gix-mkrspc/internet-of-porg/assets/9.jpeg

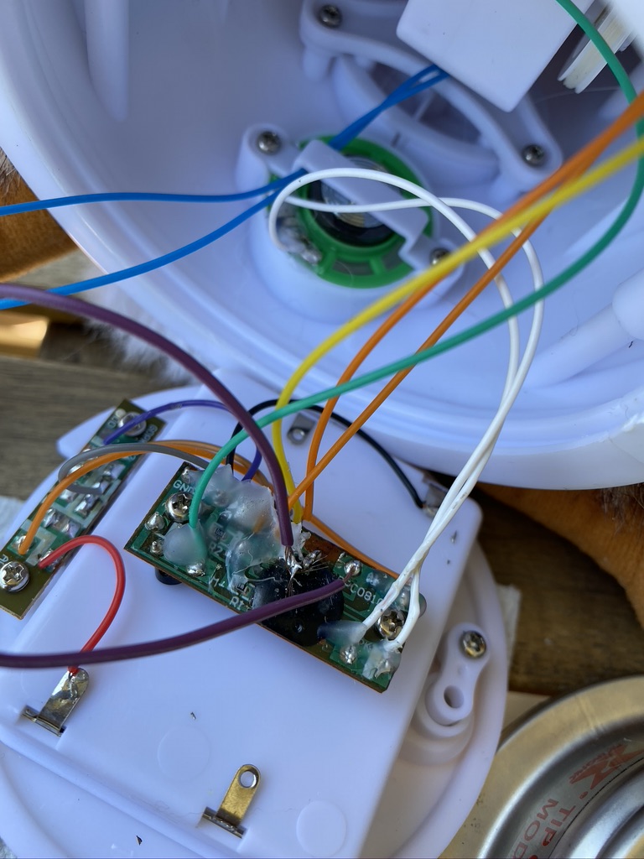
assets/9.jpeg
