gix-mkrspc/internet-of-porg/assets/14.png

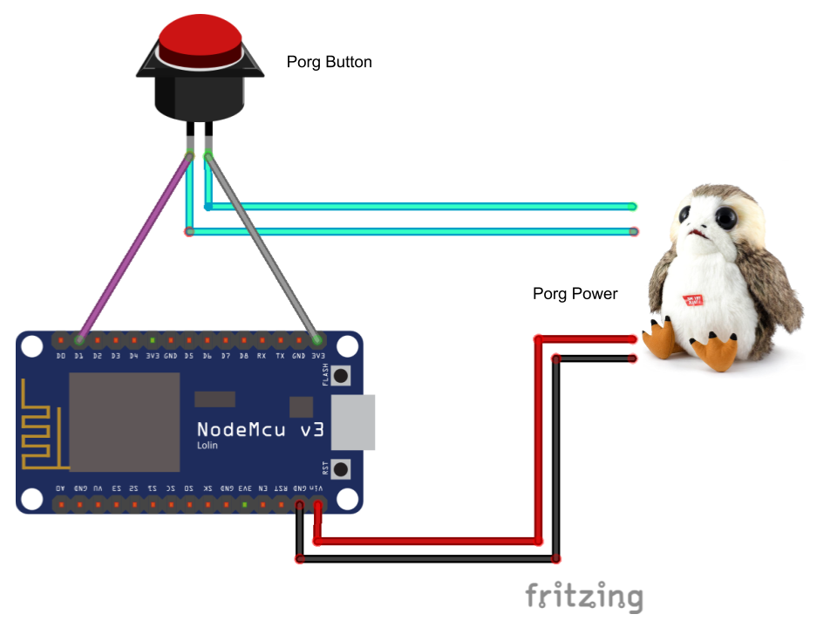
assets/14.png
