gix-mkrspc/internet-of-porg/assets/arduino_bb.png

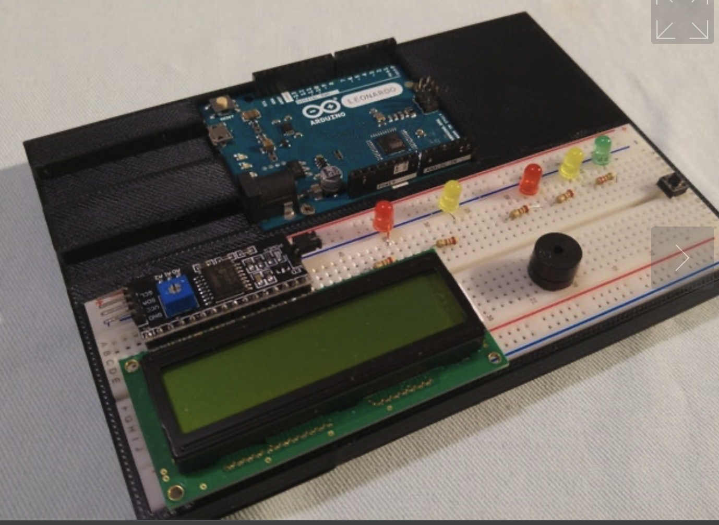
assets/arduino_bb.png
