gix-mkrspc/internet-of-porg/assets/azure/1.png

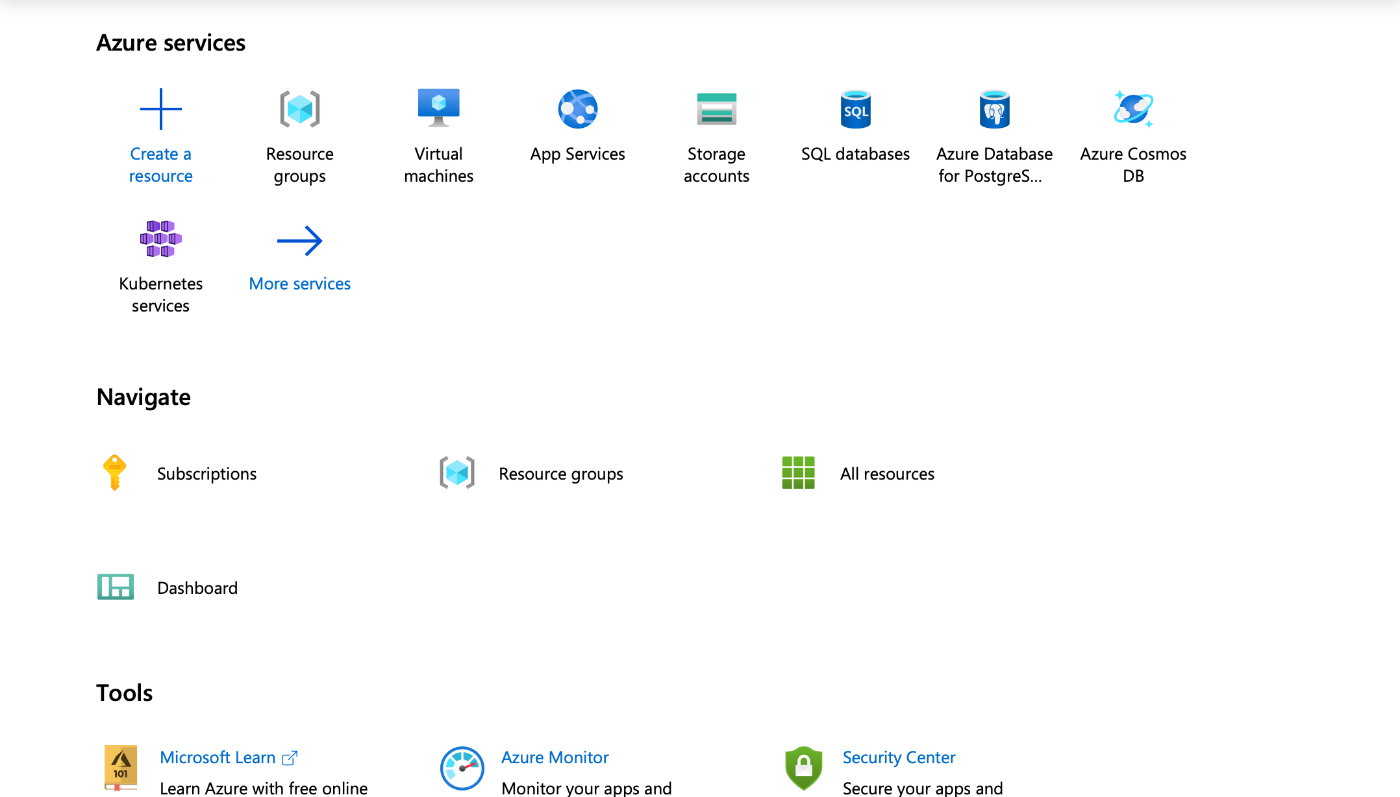
assets/azure/1.png
