gix-mkrspc/internet-of-porg/assets/azure/2.png

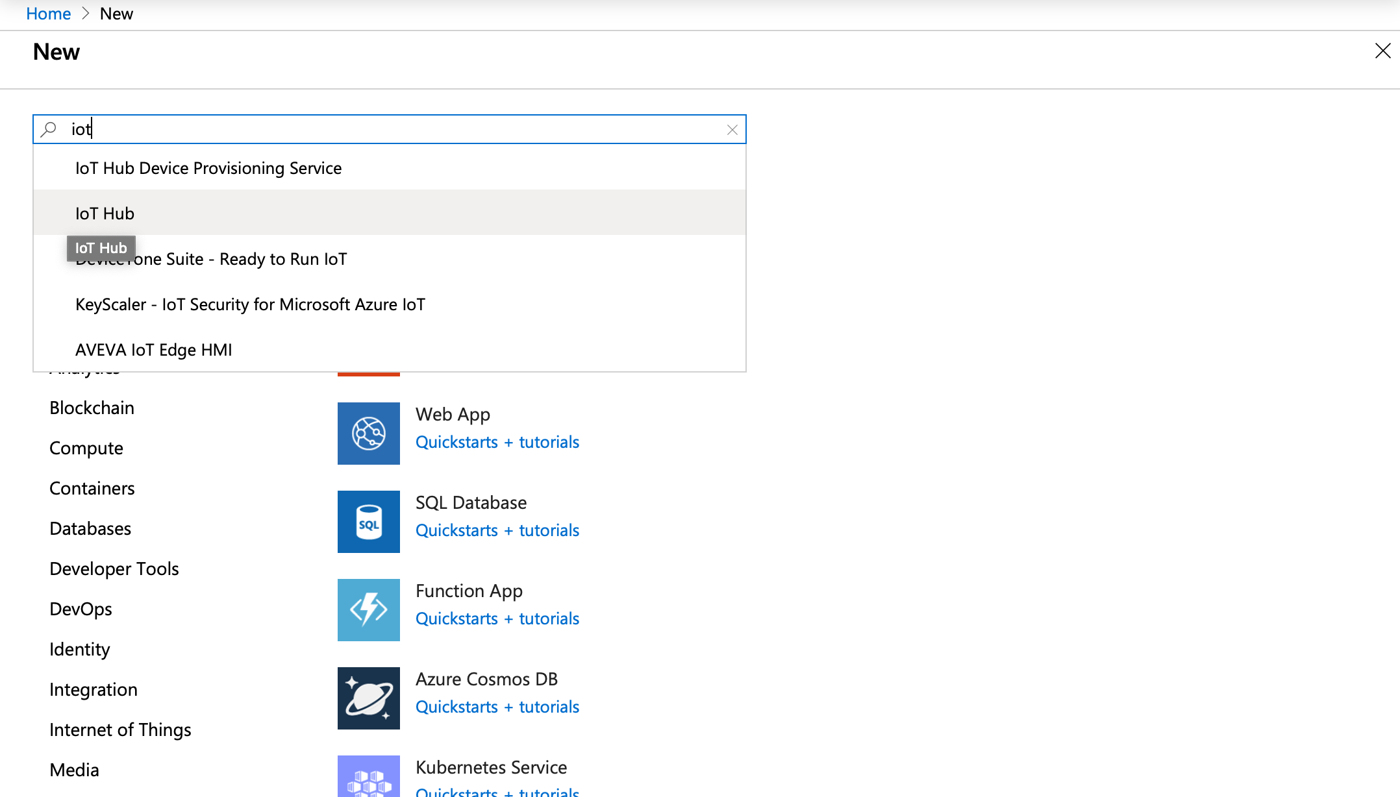
assets/azure/2.png
