gix-mkrspc/internet-of-porg/assets/azure/3.png

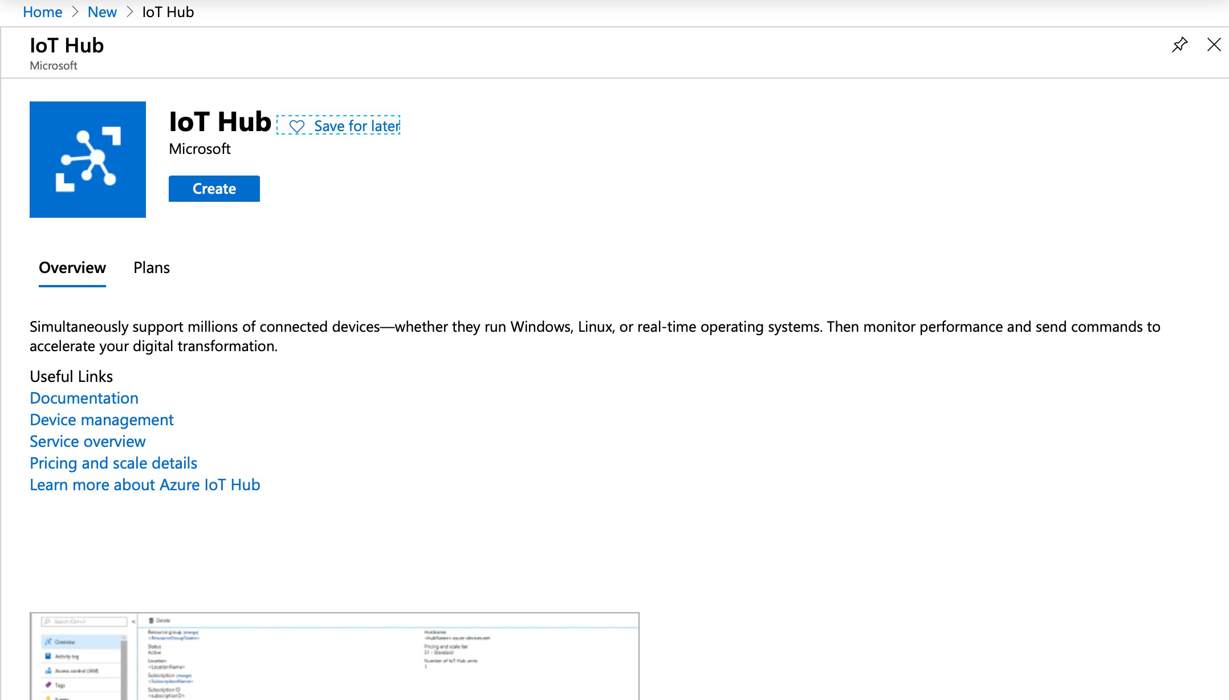
assets/azure/3.png
