gix-mkrspc/internet-of-porg/assets/azure/4.png

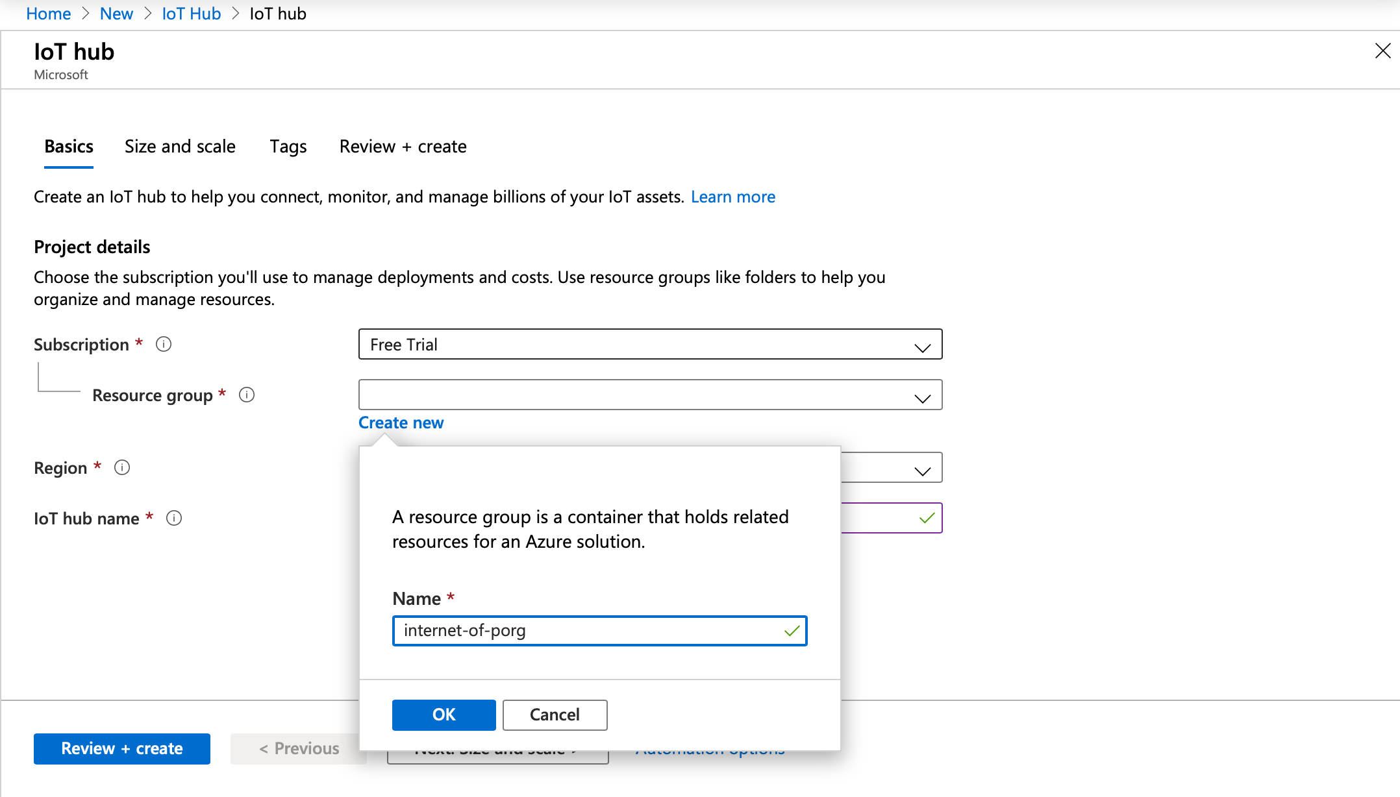
assets/azure/4.png
