gix-mkrspc/internet-of-porg/assets/azure/5.png

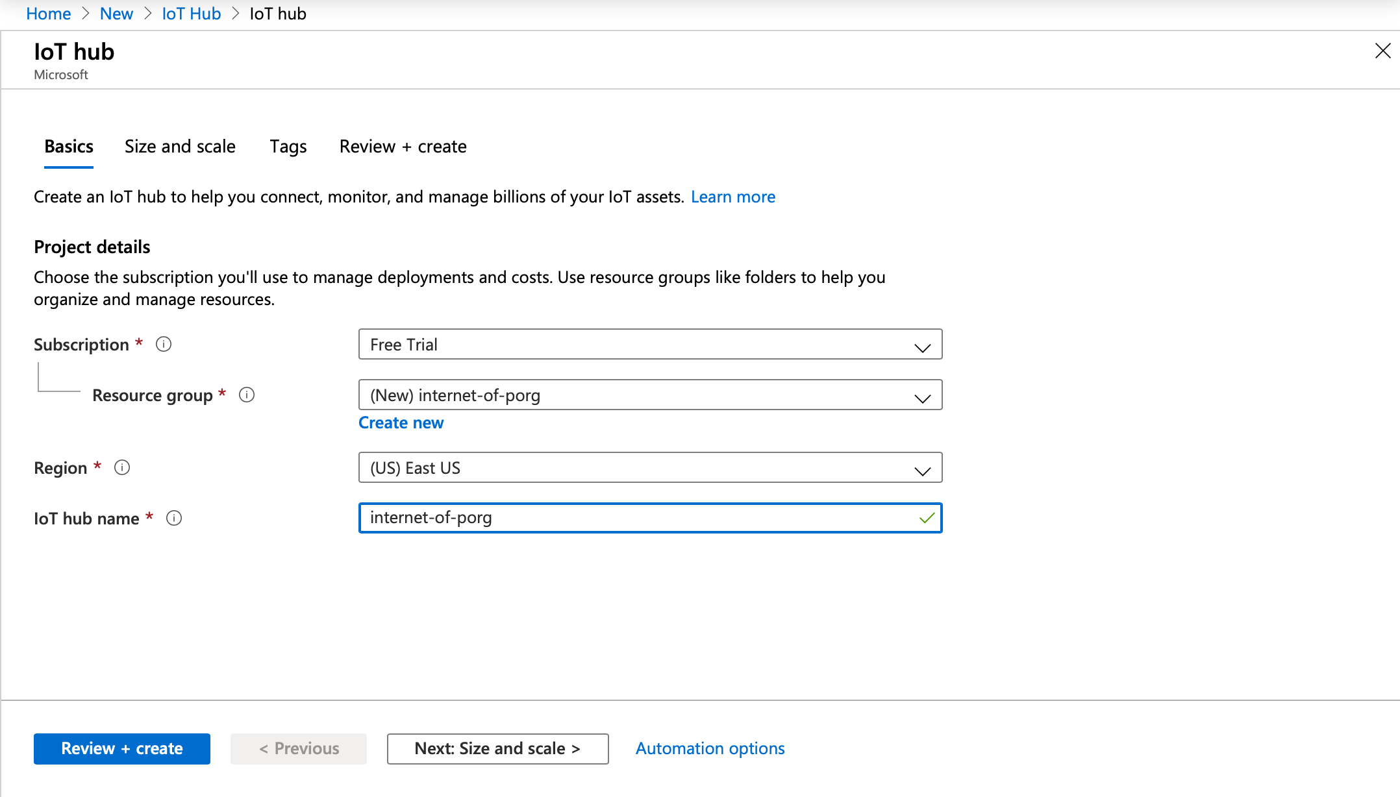
assets/azure/5.png
