gix-mkrspc/internet-of-porg/assets/azure/6.png

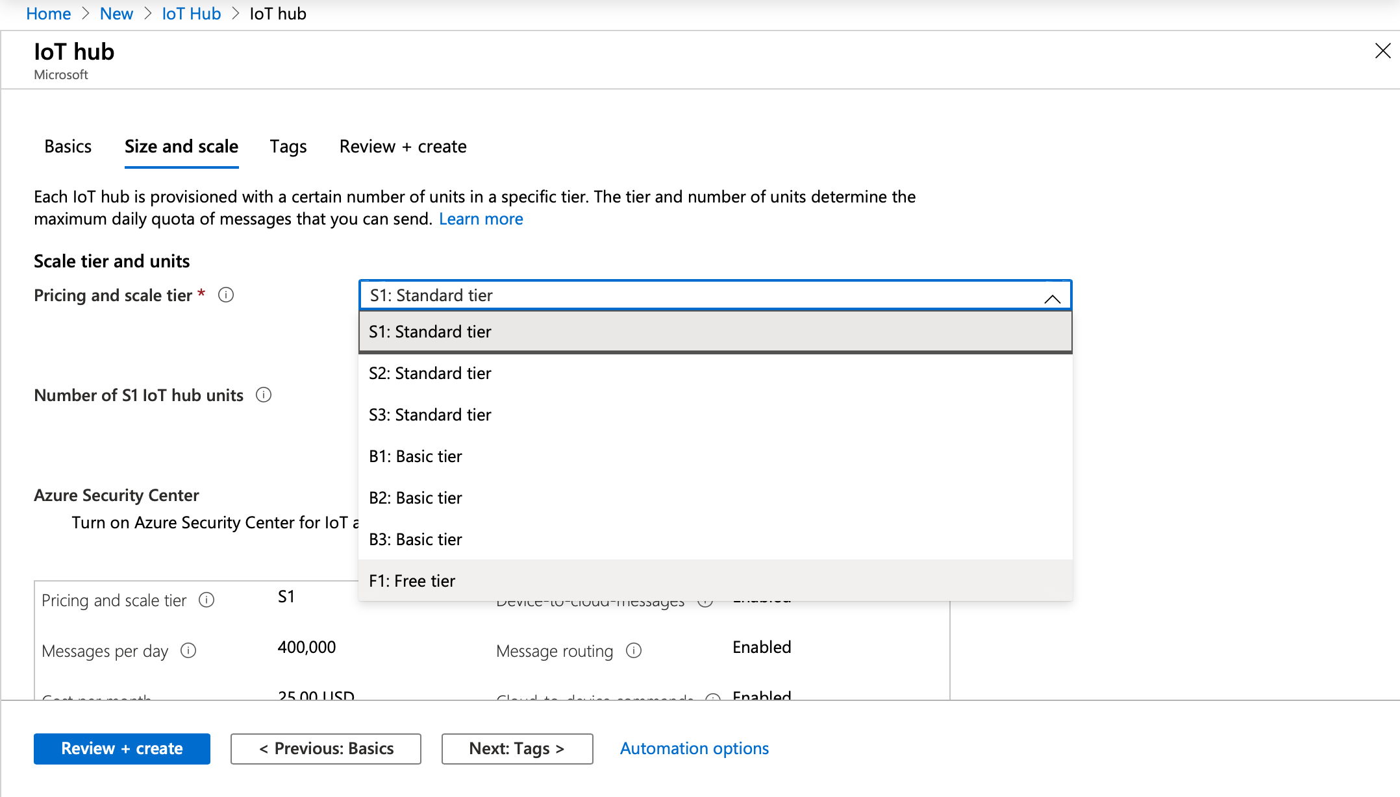
assets/azure/6.png
