gix-mkrspc/internet-of-porg/assets/azure/7.png

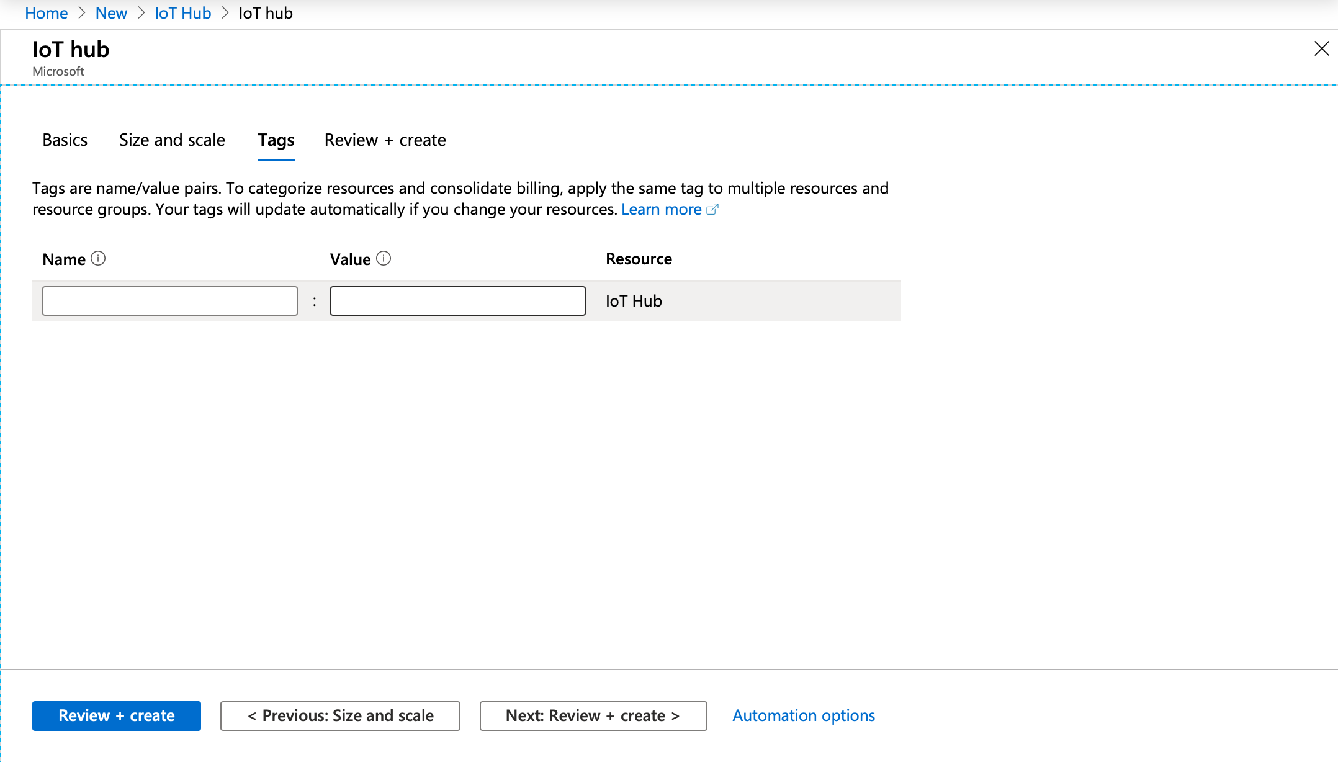
assets/azure/7.png
