gix-mkrspc/internet-of-porg/assets/azure/8.png

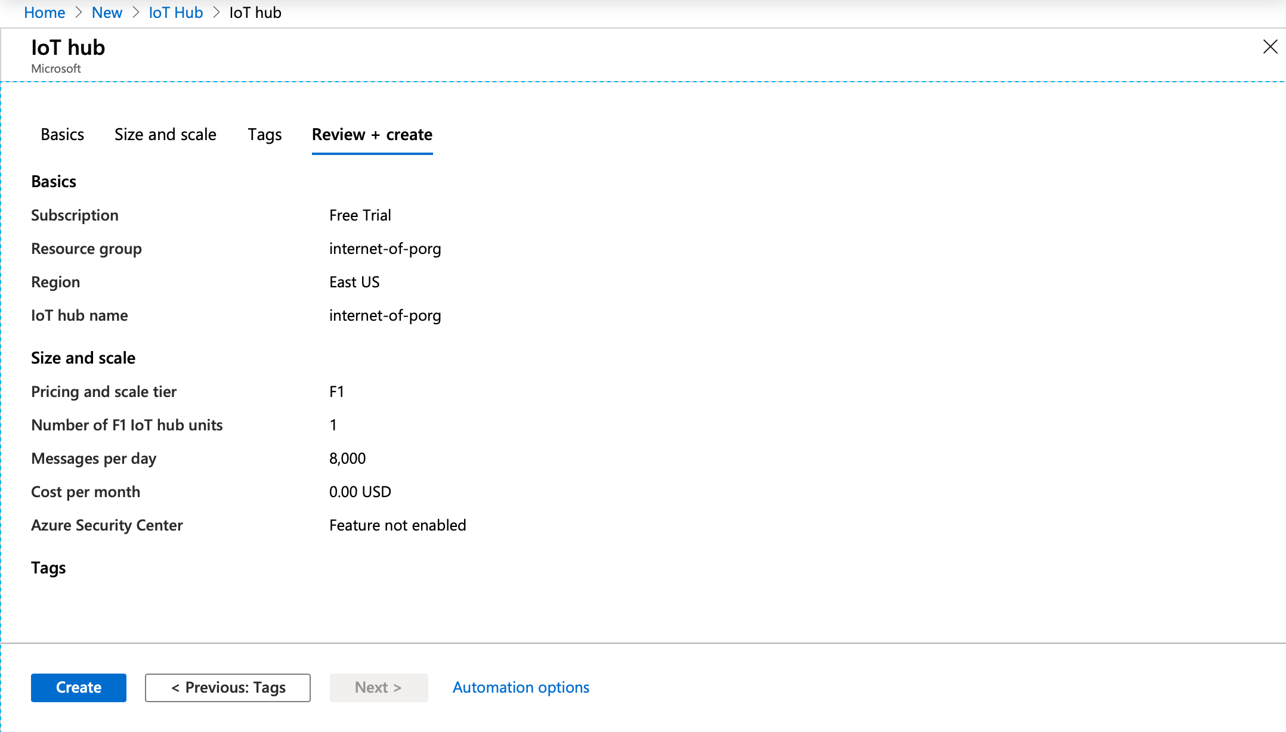
assets/azure/8.png
