gix-mkrspc/internet-of-porg/assets/azure/9.png

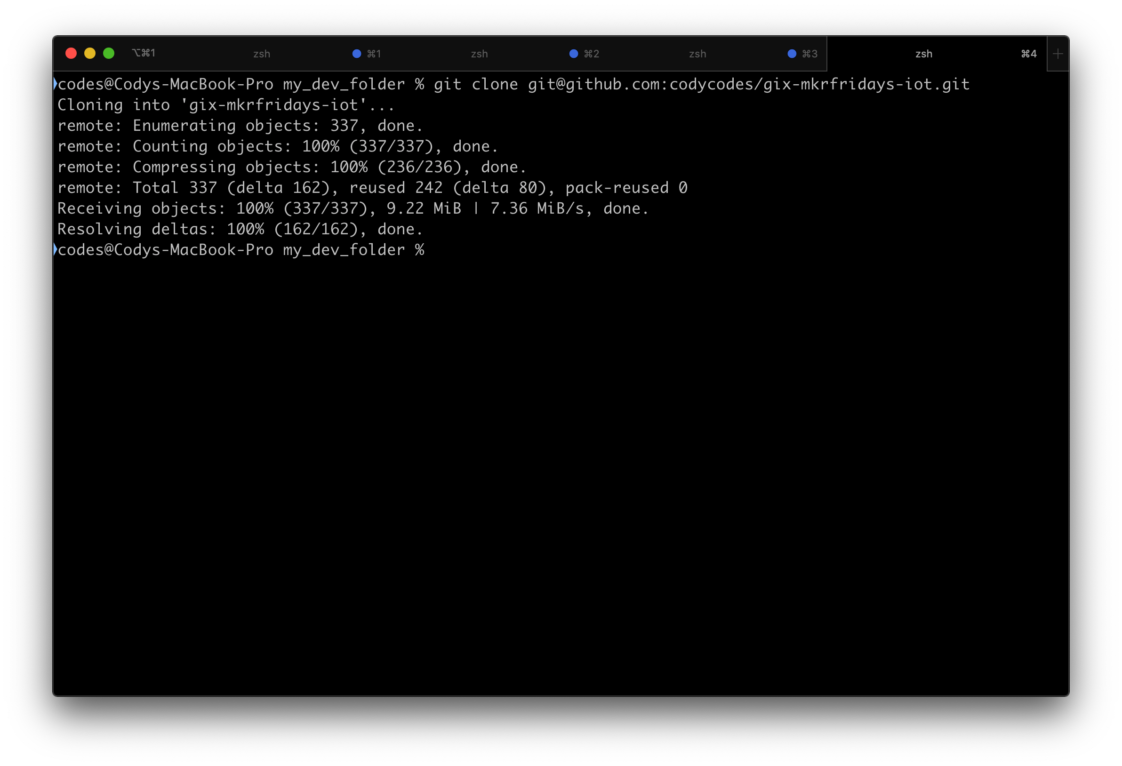
assets/azure/9.png
