gix-mkrspc/internet-of-porg/assets/azure/11.png

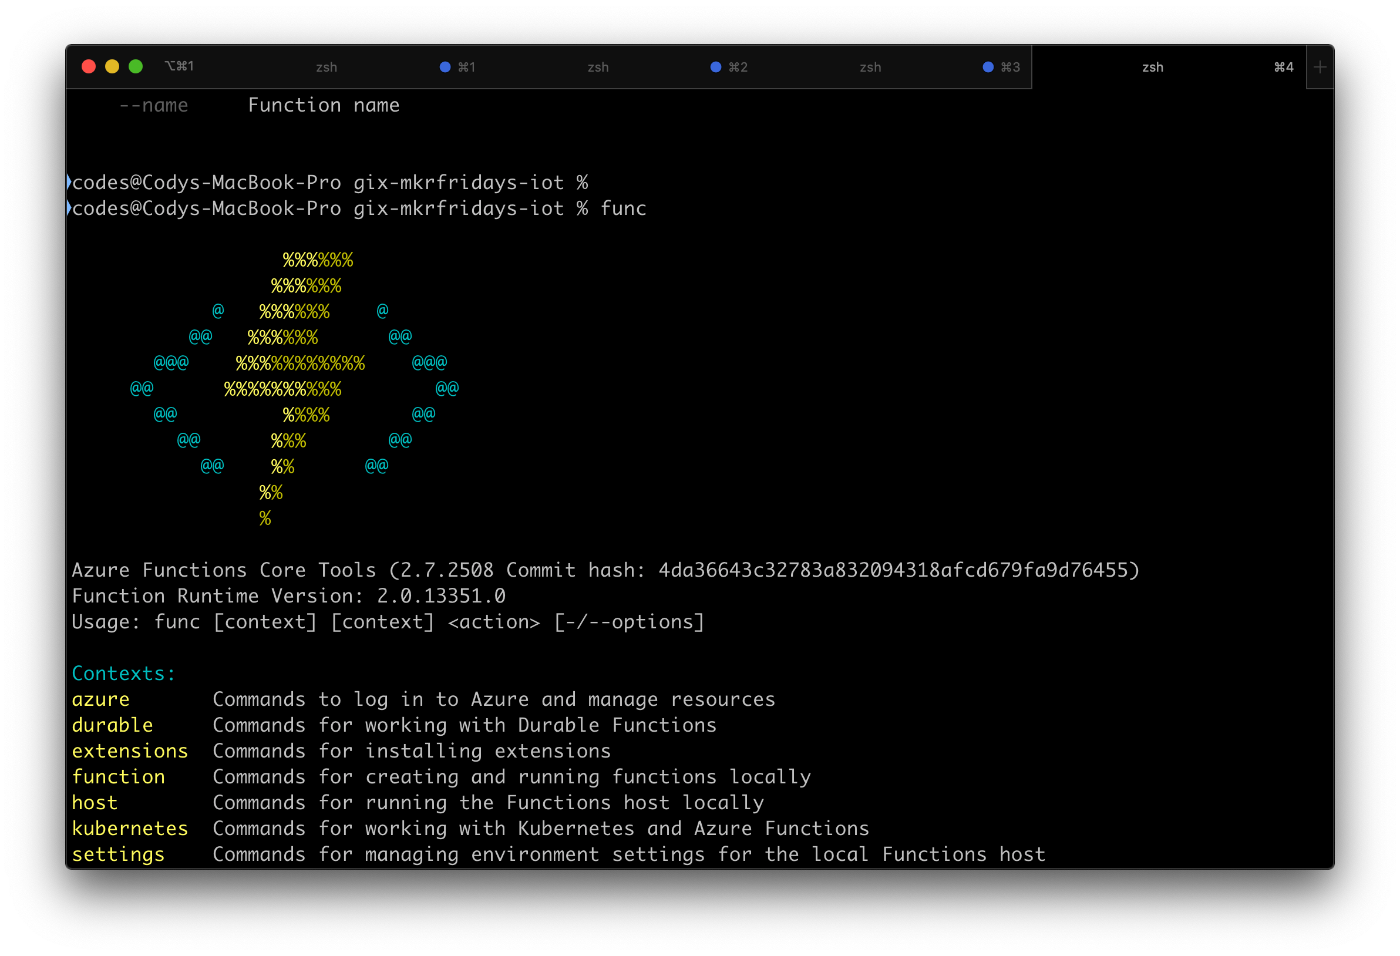
assets/azure/11.png
