gix-mkrspc/internet-of-porg/assets/azure/12.png

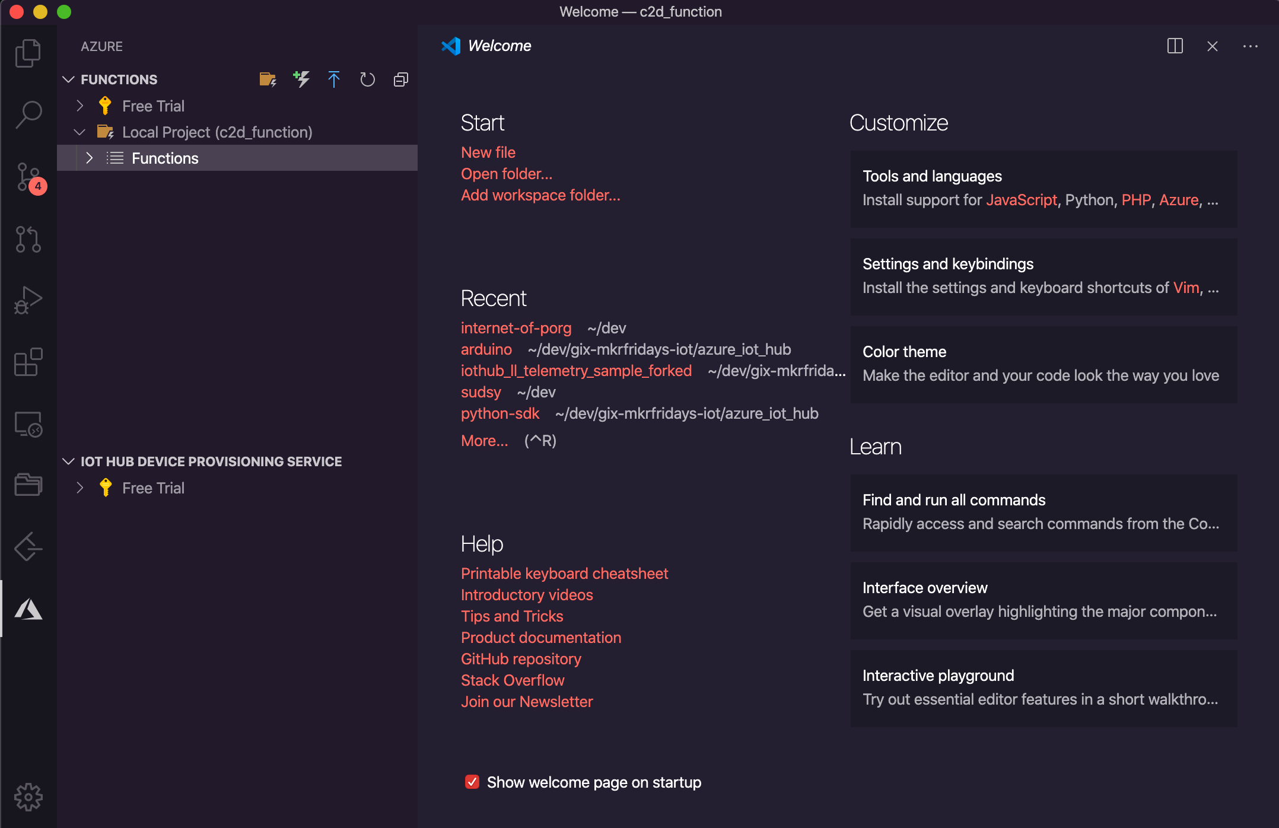
assets/azure/12.png
