gix-mkrspc/internet-of-porg/assets/azure/13.png

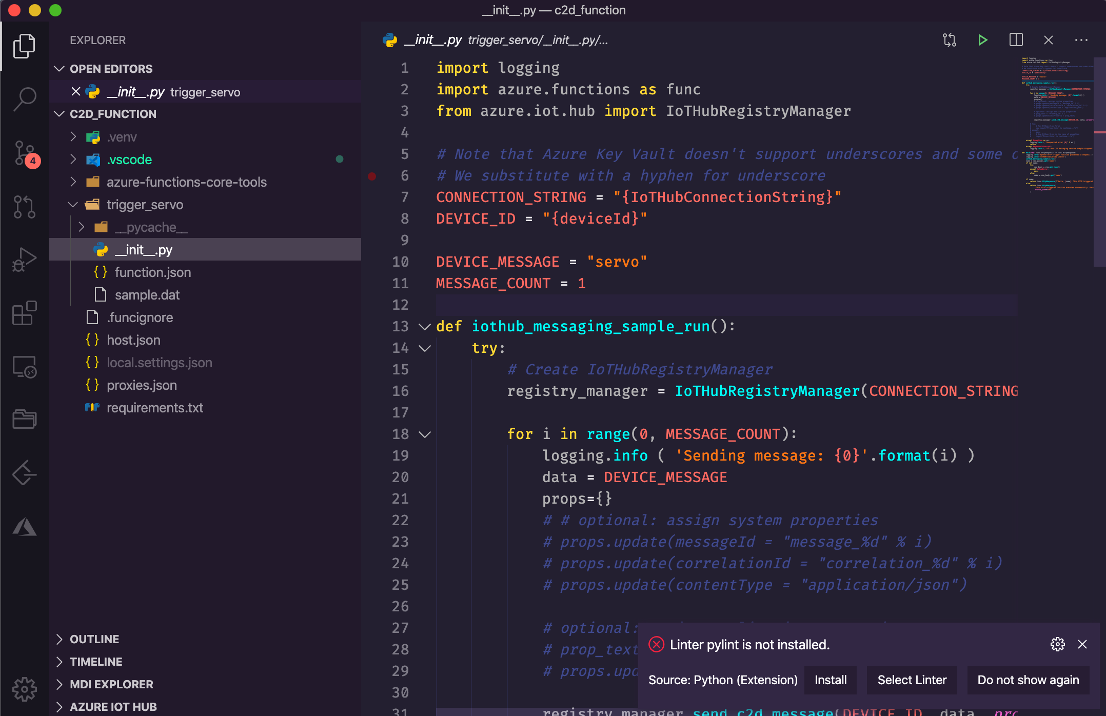
assets/azure/13.png
