gix-mkrspc/internet-of-porg/assets/azure/14.png

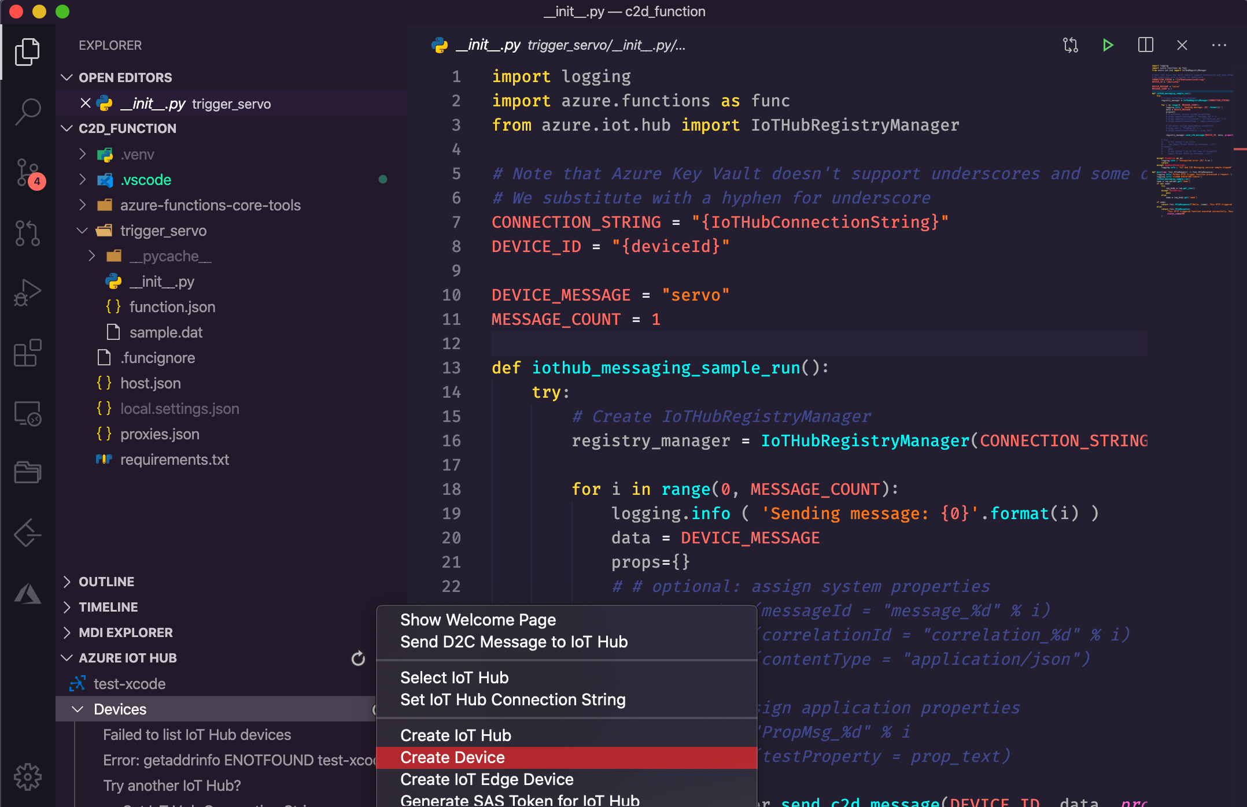
assets/azure/14.png
