gix-mkrspc/internet-of-porg/assets/azure/18.png

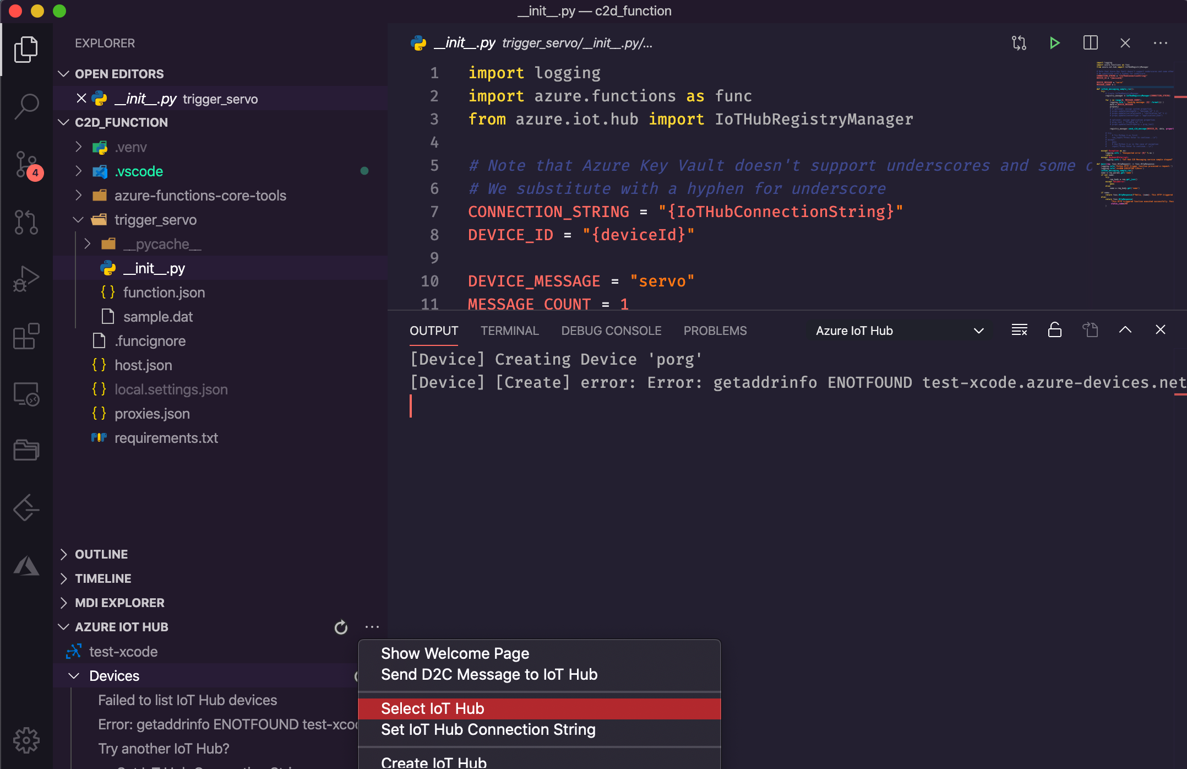
assets/azure/18.png
