gix-mkrspc/internet-of-porg/assets/azure/19.png

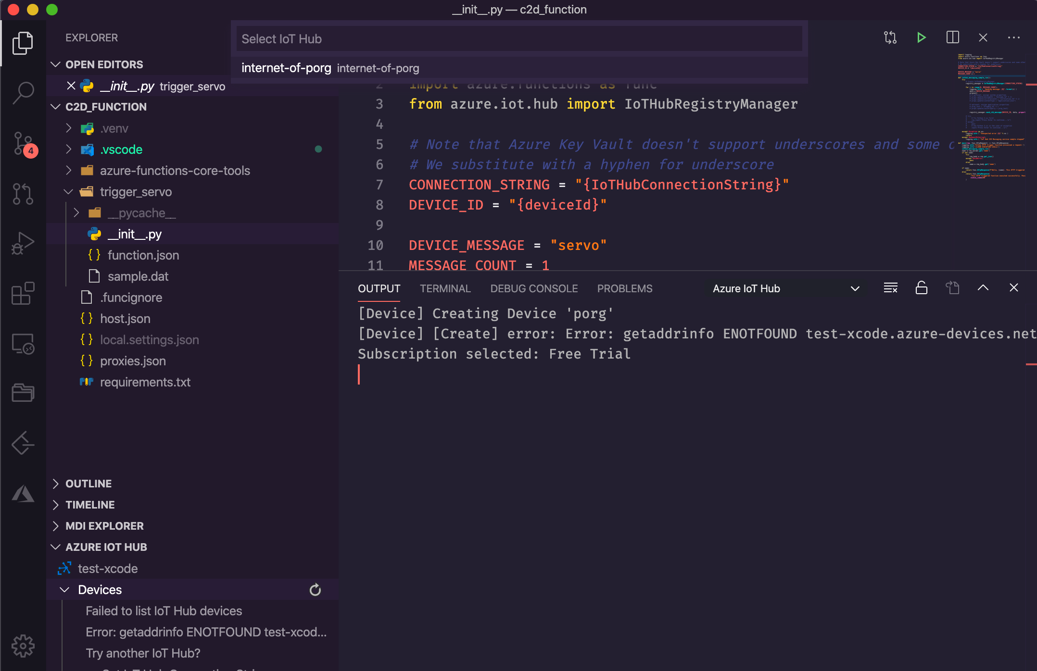
assets/azure/19.png
