gix-mkrspc/internet-of-porg/assets/azure/20.png

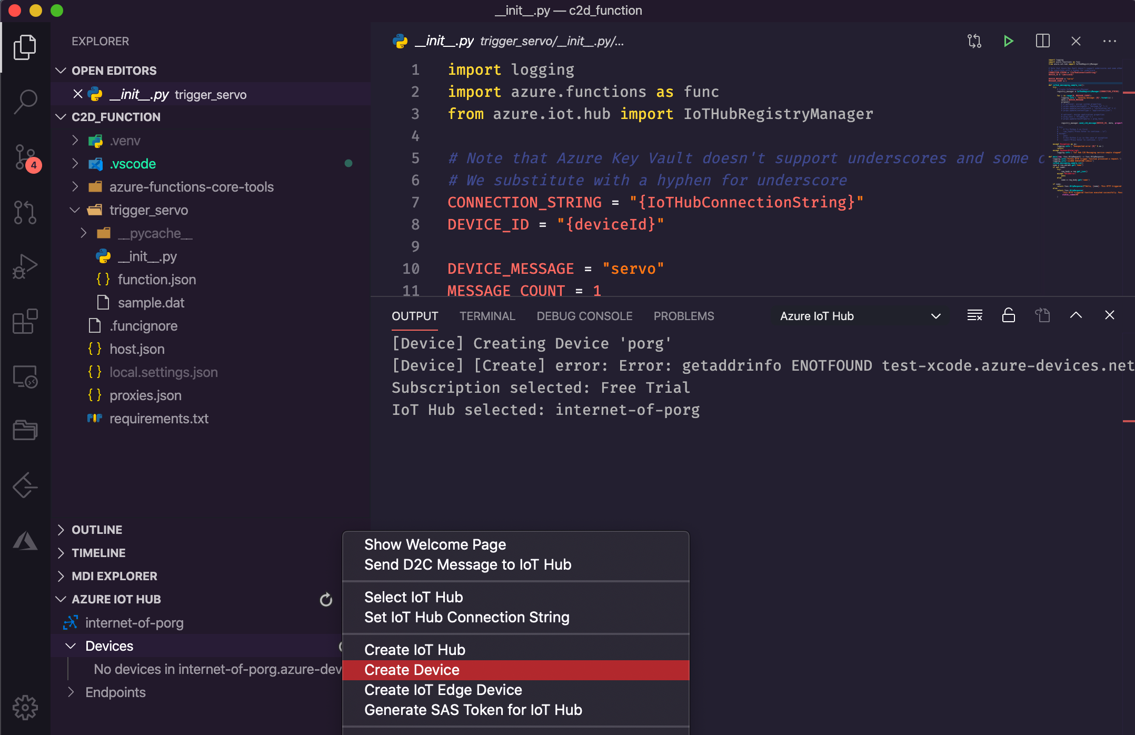
assets/azure/20.png
