gix-mkrspc/internet-of-porg/assets/azure/23.png

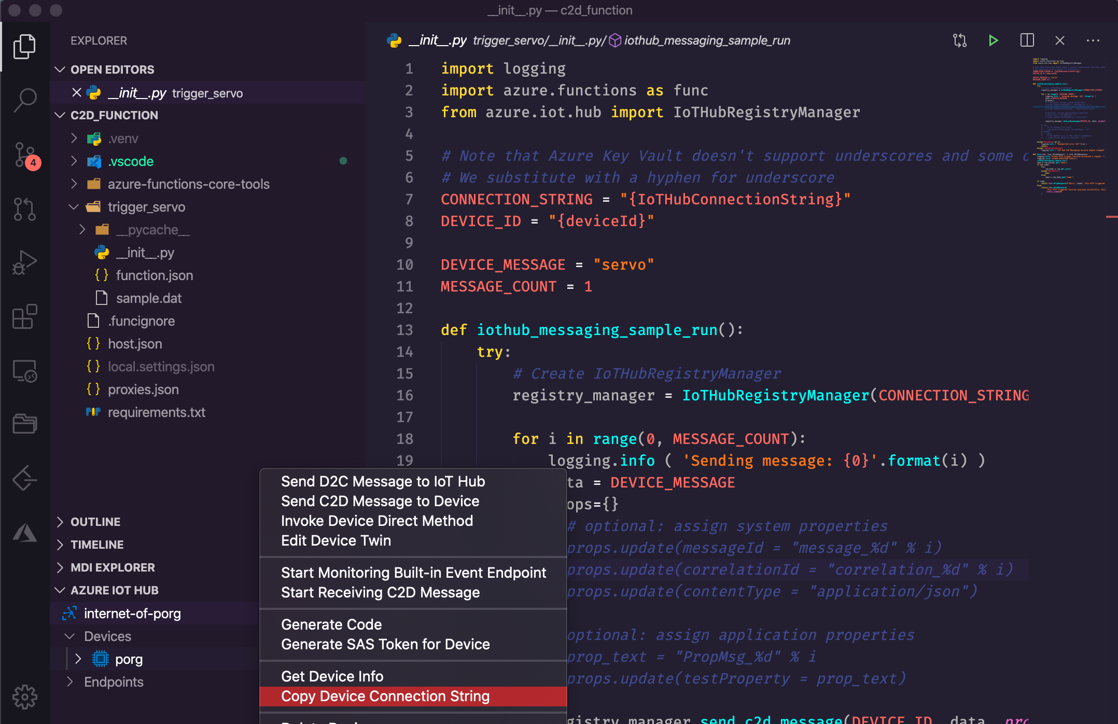
assets/azure/23.png
