gix-mkrspc/internet-of-porg/assets/azure/24.png

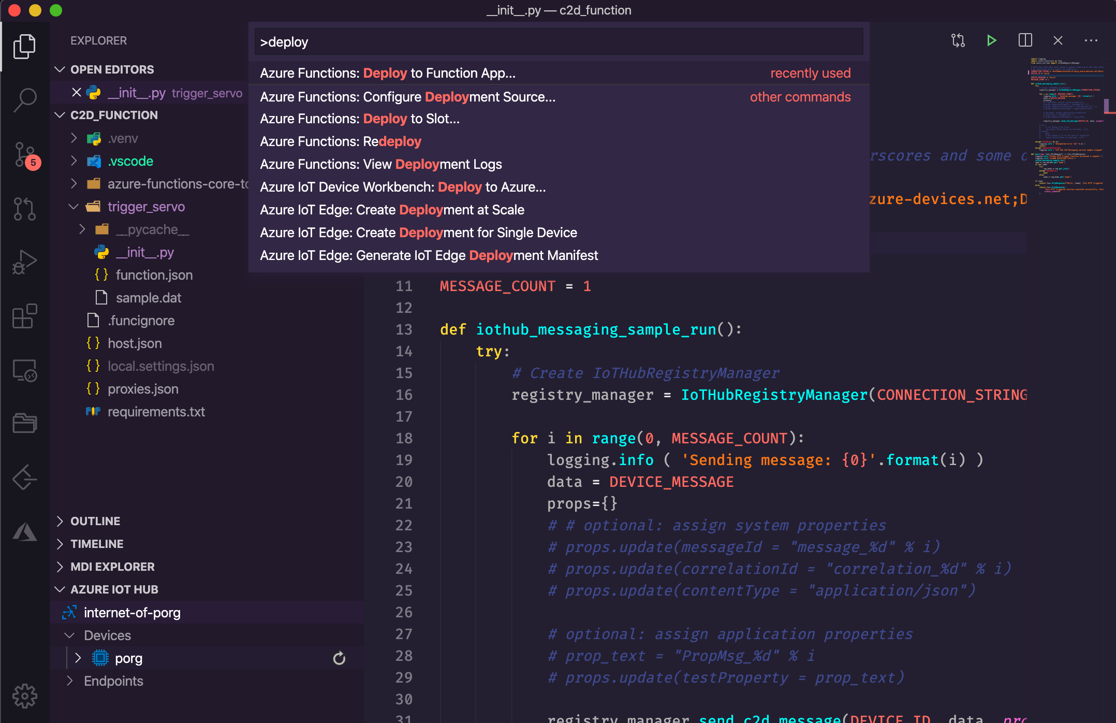
assets/azure/24.png
