gix-mkrspc/internet-of-porg/assets/azure/25.png

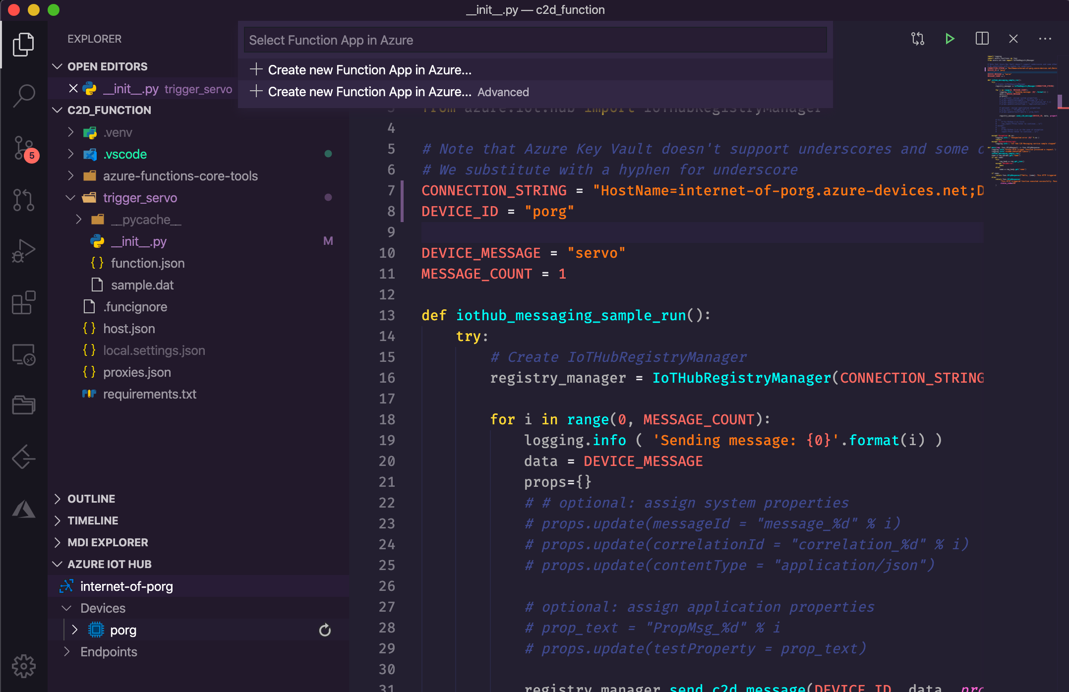
assets/azure/25.png
