gix-mkrspc/internet-of-porg/assets/azure/28.png

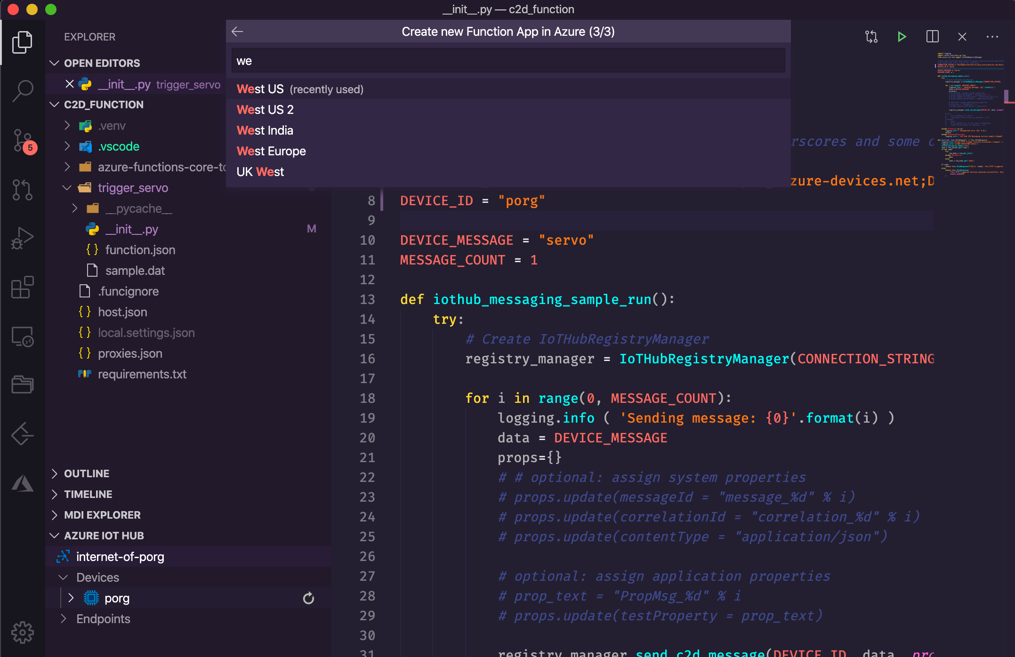
assets/azure/28.png
