gix-mkrspc/internet-of-porg/assets/azure/29.png

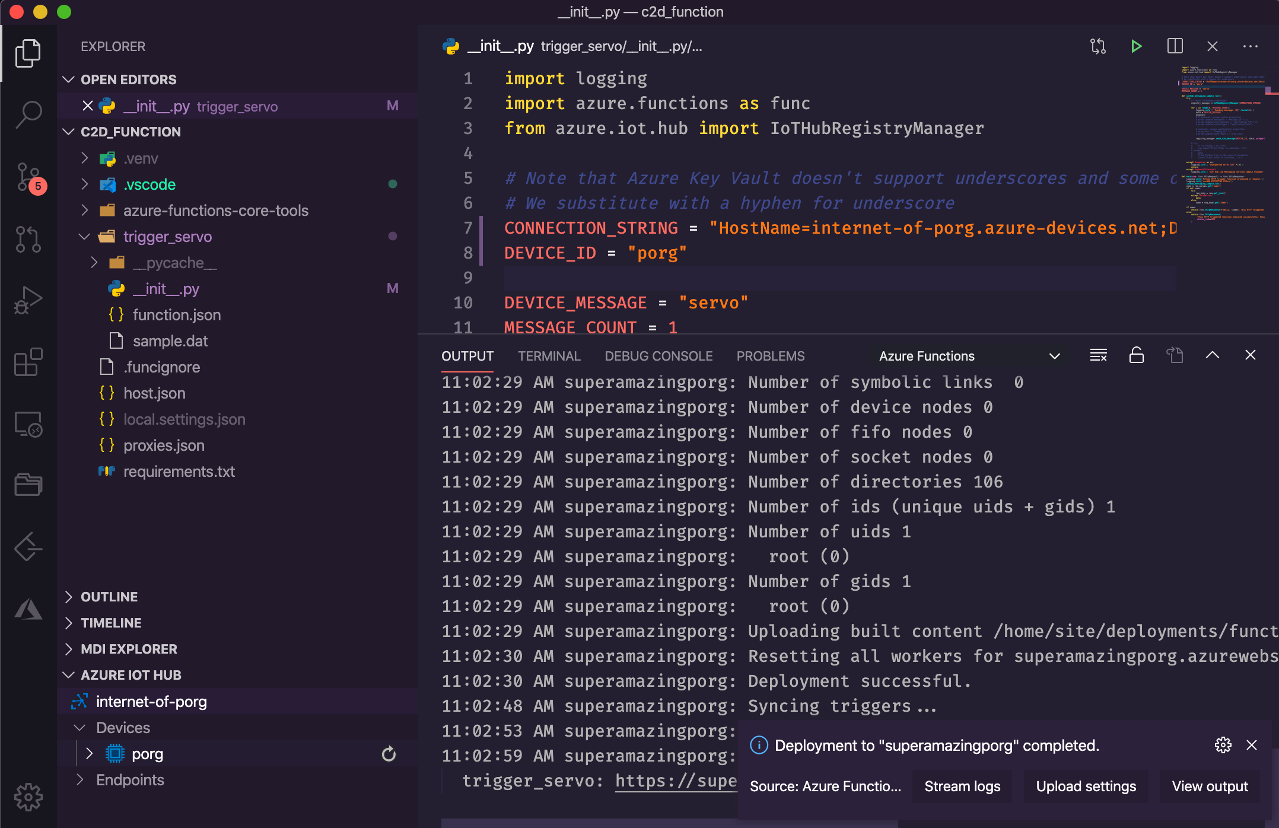
assets/azure/29.png
