gix-mkrspc/internet-of-porg/assets/azure/30.png

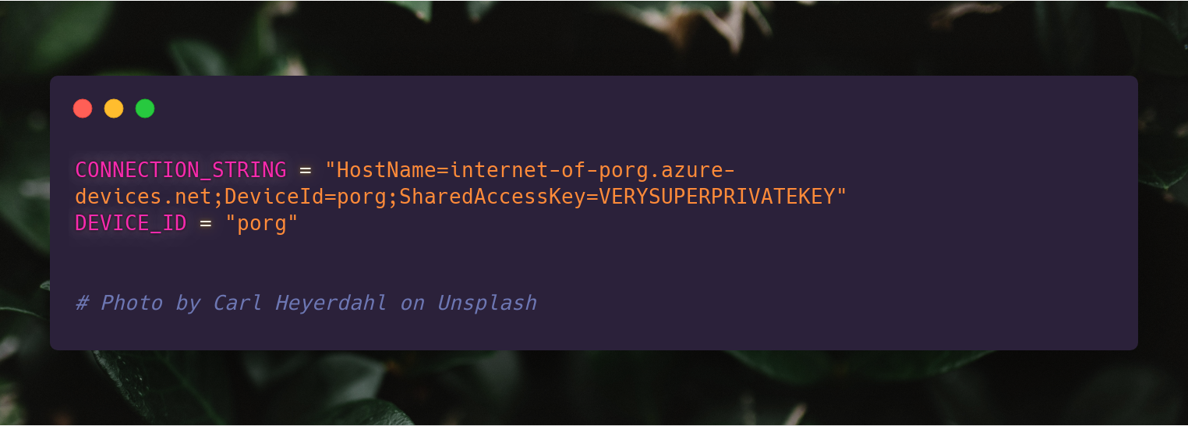
assets/azure/30.png
