gix-mkrspc/internet-of-porg/assets/porg_bb.jpeg

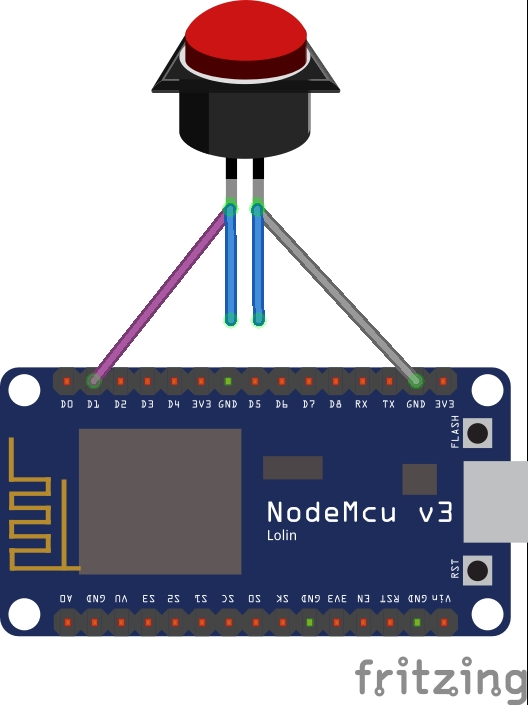
assets/porg_bb.jpeg
