gix-mkrspc/internet-of-porg/assets/sample_qr.png

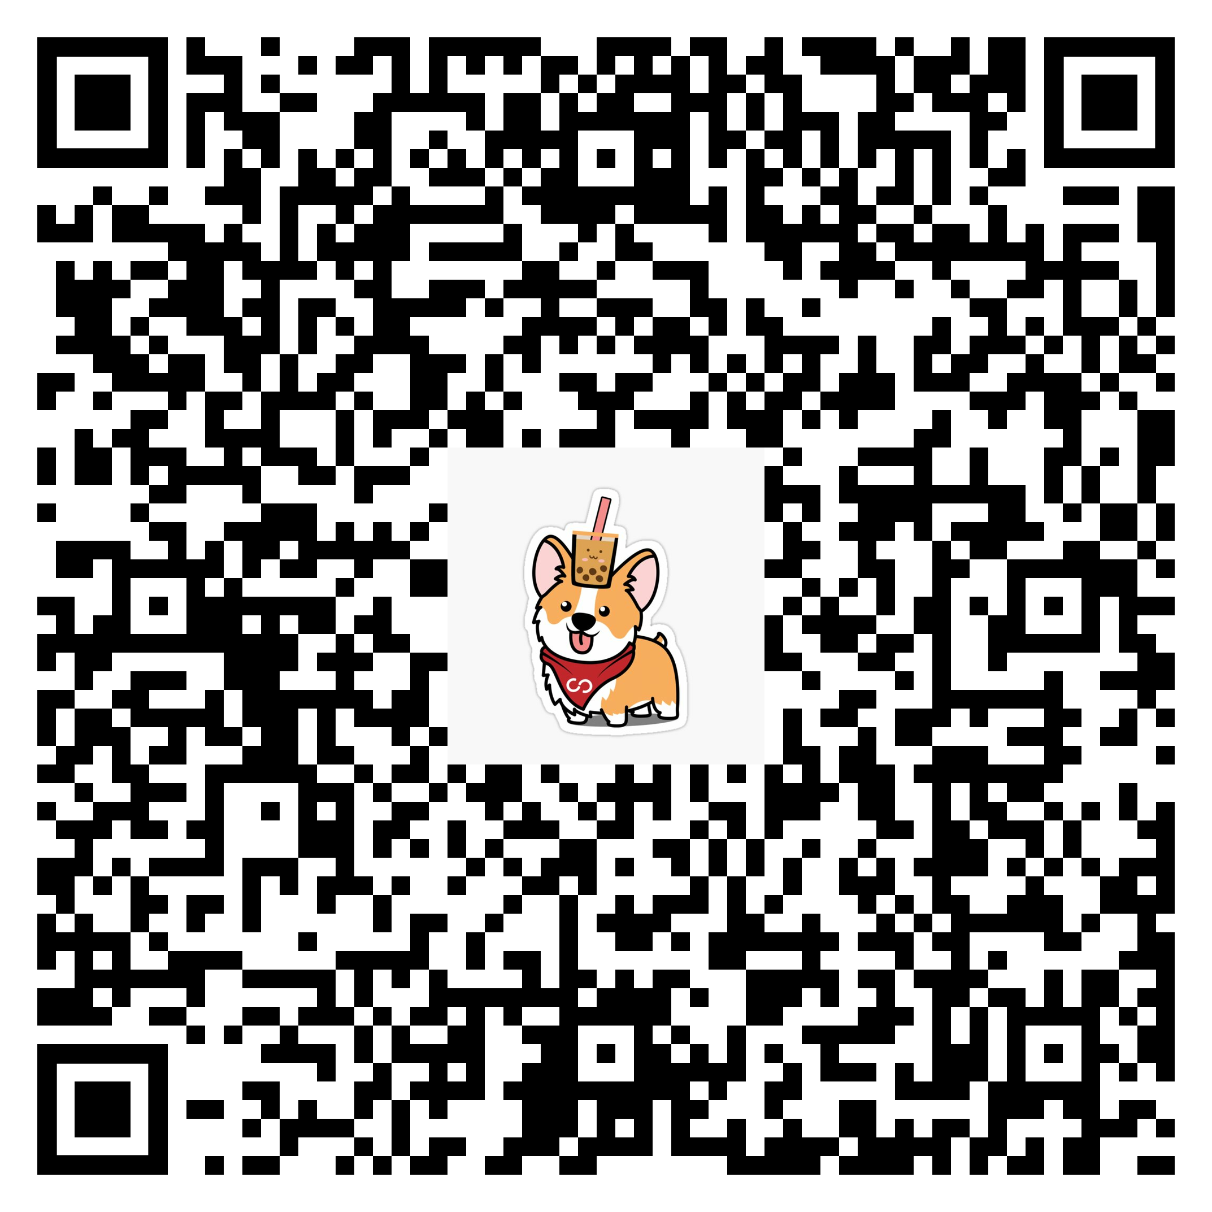
assets/sample_qr.png
