gix-mkrspc/internet-of-porg/assets/shield.png

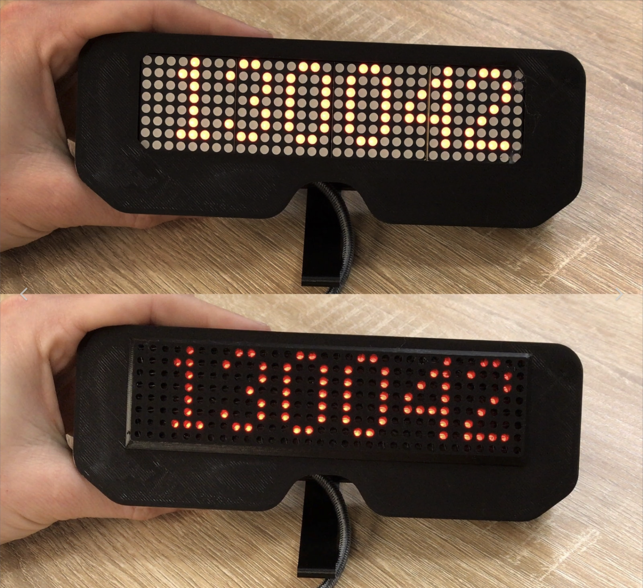
assets/shield.png
