gix-mkrspc/internet-of-porg/assets/solder_no_battery.jpeg

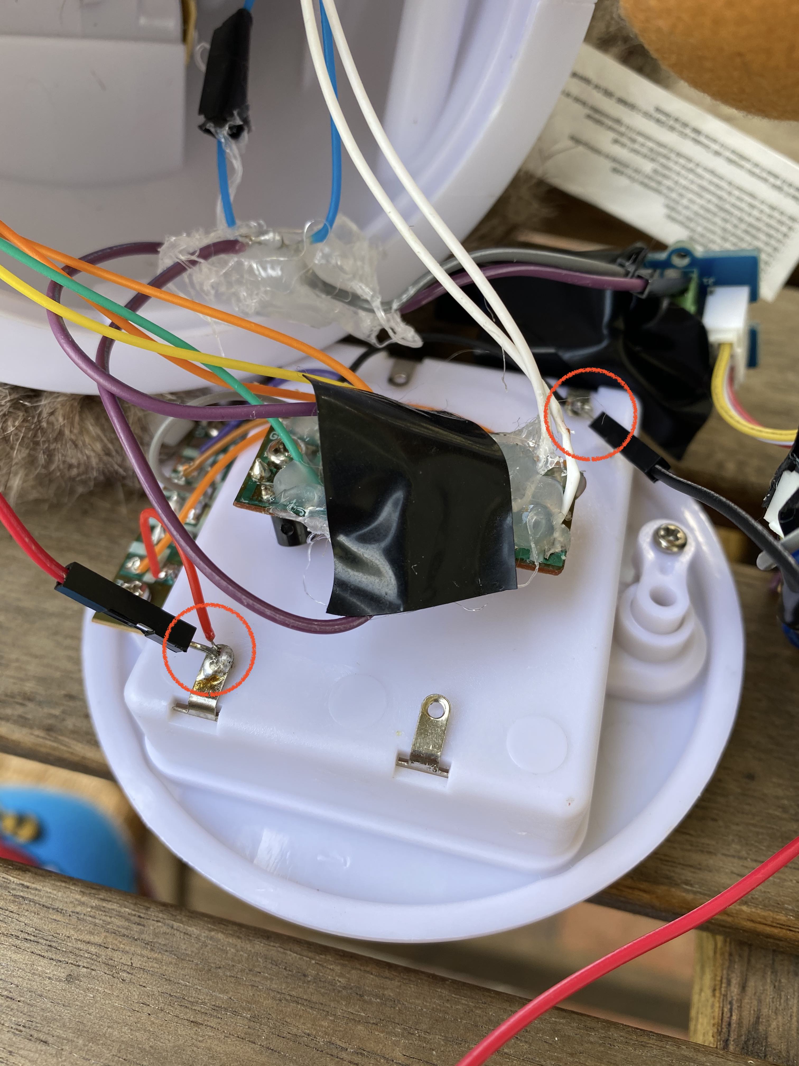
assets/solder_no_battery.jpeg
