gix-mkrspc/internet-of-porg/(commit log)

2020-05-15 :pencil: Add ARM resource sample link
2020-05-20 :pencil: Add gh buttons, weekly update
2020-05-20 :pencil: Add materials
2020-05-20 :bento: Add circuit diagram
2020-06-11 :pencil2: Formatting, add materials
2020-06-11 :bento: Add solder no battery image
2020-07-13 :construction: Guide for USB powered porg
2020-10-24 :memo: Update materials
2020-10-25 :memo: Update walkthrough for USB power
2020-10-25 :memo: Sample porg files
2020-10-25 :memo: Note for relay porg
