gix-mkrspc/internet-of-porg/assets/usb_9.jpg

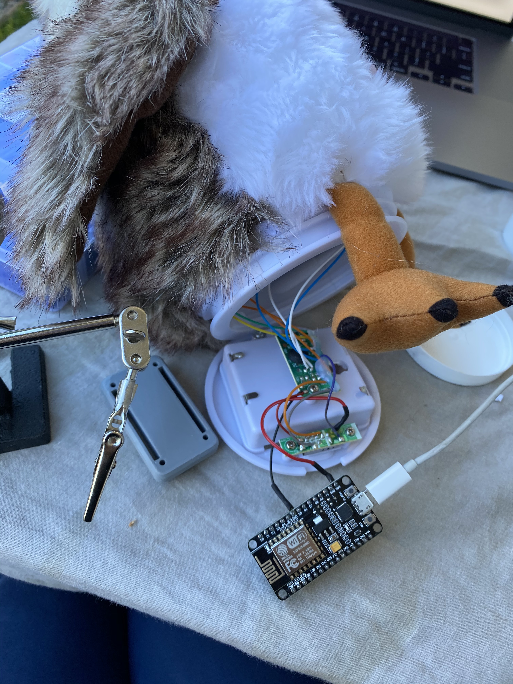
[picture p19: assets/usb_9.jpg]
assets/usb_9.jpg
