gix-mkrspc/internet-of-porg/assets/usb_10.jpg

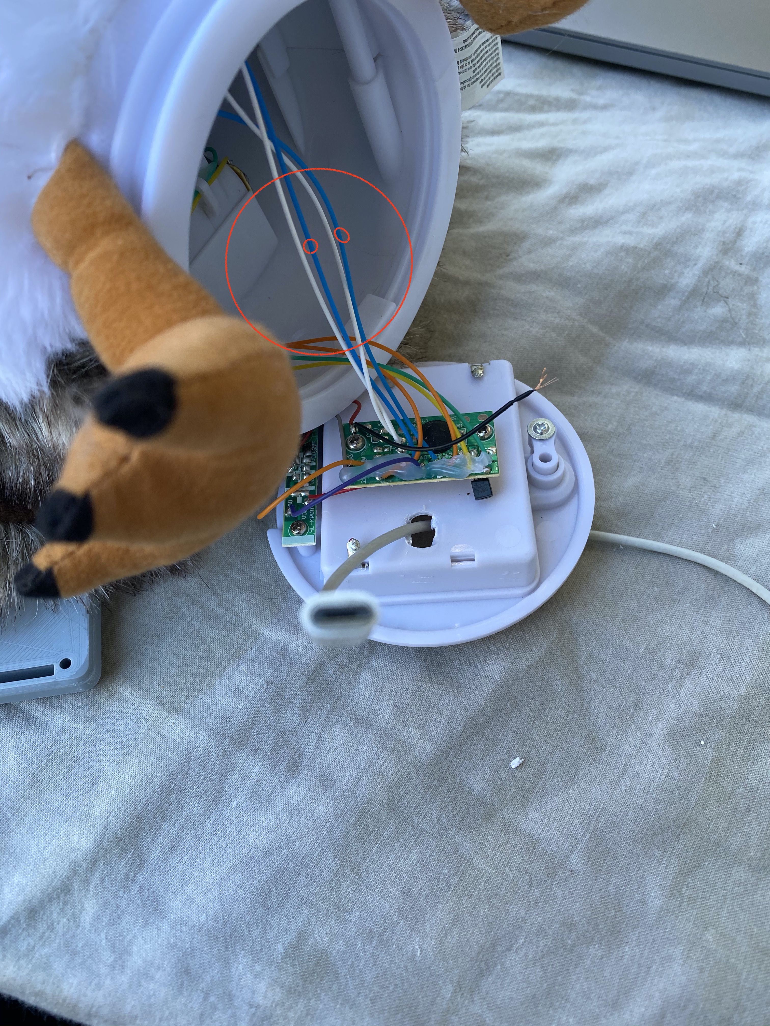
[picture p20: assets/usb_10.jpg]
assets/usb_10.jpg
