gix-mkrspc/internet-of-porg/assets/usb_12.jpg

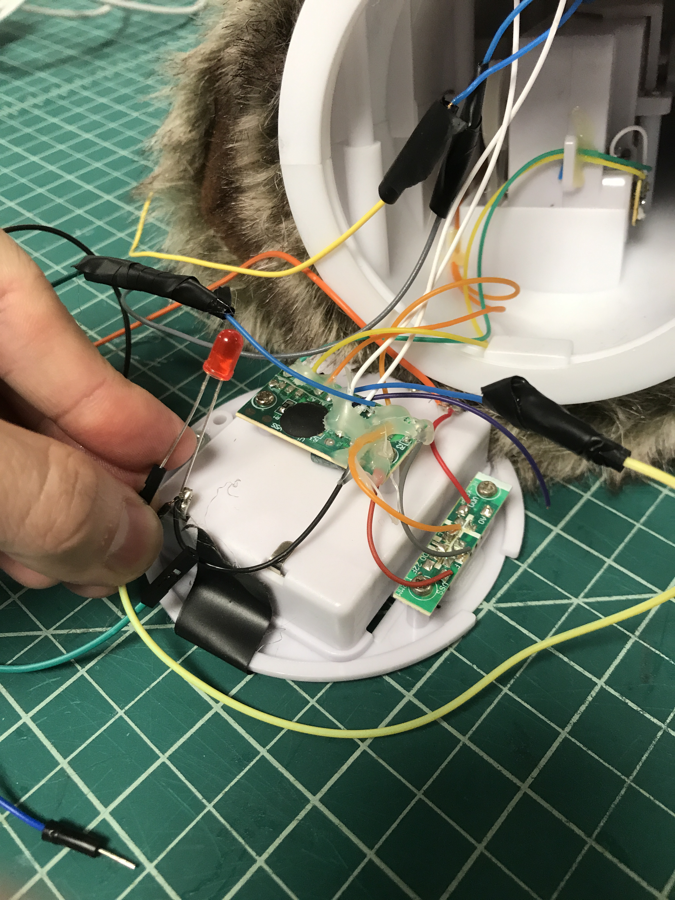
[picture p22: assets/usb_12.jpg]
assets/usb_12.jpg
